IoanTuns/greenhouse_automation_ESP_32_C3_super_mini/hardware/schematic.html

Hardware prototype · schematic reference · rev 1

# Greenhouse Controller — Schematic Prototype

A single-page circuit reference for the ESP32-C3 Super Mini greenhouse automation board, consolidating HARDWARE_CONNECTIONS.md and config_hardware.h into one drawing. This is the basis for the KiCad schematic/PCB files that follow — not a physical footprint layout.

MCUESP32-C3 Super Mini

Power rails12V → 5V → 3.3V

Sensors5 (RTC, baro, RH/T, 2× temp)

Actuators3 relays, 2 solenoids, 1 pump

Flow inputs2 zones, interrupt-driven

GPIOs used16 of 22

## 01 Power distribution

One 12V supply is stepped down twice. The split matters for the board layout: 12V feeds the switched loads directly, 5V feeds motor/coil-side and card logic, and 3.3V is the sensor and relay-logic rail — mixing these up is what damages the ESP32-C3's I/O.

12V feeds the buck converter and the switched valve/pump loads directly; the buck converter's 5V drives the ESP32, relay coil rail, and SD card; a downstream AMS1117 makes the 3.3V rail every sensor and the relay logic side share with the ESP32's own 3V3 pin.

## 02 ESP32-C3 pin assignment

All 16 assigned GPIOs, color-coded by net class. GPIO 8 and 9 carry boot-strapping constraints (LED loading, BOOT button) documented in config_hardware.h — both are safe here because relays default active-LOW/HIGH-off, matching the pins' natural boot state.

Power Ground I2C bus SPI bus Relay output Sensor data Interrupt input

GPIO 11–19 are unused (18/19 reserved for USB-CDC serial). Every non-power, non-ground pin here needs the passive support shown in §03 before it's safe to route to the ESP32.

## 03 Protection circuits

Six passive networks stand between the ESP32-C3 and the outside world. Skipping any one of these is what produces the failure modes already logged in the wiring doc: -127°C readings, CRC errors, boot-loop into download mode, or a fried GPIO.

Relay logic isolation

Removes the VCC↔JD-VCC jumper so onboard pull-ups reference 3.3V, not 5V — keeps GPIO 8/9 under the C3's 3.6V max during boot.

Flow-meter voltage divider

5V × 20k/(10k+20k) = 3.33V at the pin. Required per zone — the bare 5V signal exceeds the GPIO's absolute max and will destroy it.

One-wire & DHT pull-ups

The C3's internal ~45kΩ pull-up is too weak for either protocol. Without these, expect −127°C stub readings or DHT CRC failures.

SD MISO boot-strap pull-up

Without it, a floating tri-stated MISO can read LOW at reset and drop the C3 into ROM download mode instead of booting firmware.

Solenoid flyback diode

Cathode toward +12V, one diode per valve, in parallel with the coil — clamps the collapse spike that would otherwise arc the relay contacts.

Pump RC snubber

R+C in series, wired across relay 1's switched contacts — suppresses arcing on the 220V AC pump circuit specifically.

## 04 Bill of materials

Grouped by role. Passive values match the protection insets above; buy resistors in 1% tolerance for the flow-meter dividers since the 3.33V target sits close to the 3.6V absolute max.

Group | Component | Qty | Spec | Notes
Core | ESP32-C3 Super Mini | 1 | RISC-V, Wi-Fi | Main controller
Core | DS3231 RTC module | 1 | I2C 0x68 | Offline timekeeping
Core | BMP180 barometer | 1 | I2C 0x77 | Shares RTC's I2C bus
Core | DHT22 | 1 | ±0.5°C, ±2% RH | Greenhouse air climate
Core | DS18B20 | 2 | One-Wire | Parallel on one bus
Core | MicroSD card module | 1 | SPI, onboard 3.3V reg. | VCC from 5V rail
Core | 4-channel relay module | 1 | Active-LOW, opto-isolated | 1 channel spare
Core | YF-S201 flow meter | 2 | Hall effect, 5V | Zone 1 / Zone 2
Power | Buck step-down module | 1 | 12V→5V, ≥3A | e.g. LM2596-based
Power | AMS1117-3.3 module | 1 | 5V→3.3V LDO | Sensor + relay-logic rail
Protection | 1N4007 diode | 2 | Flyback | One per solenoid
Protection | RC snubber (100Ω + 0.1µF X2) | 1 | Across relay 1 contacts | Pump arc suppression, 220V AC
Resistor | 1kΩ | 3 | Relay IN series | GPIO5 / 8 / 9 protection
Resistor | 4.7kΩ | 1 | DS18B20 pull-up | GPIO0 → 3.3V
Resistor | 10kΩ | 1 | DHT22 pull-up | GPIO1 → 3.3V
Resistor | 10kΩ | 1 | SD MISO pull-up | GPIO2 → 3.3V, boot strap
Resistor | 10kΩ | 2 | Flow divider R1 | One per flow meter
Resistor | 20kΩ | 2 | Flow divider R2 | One per flow meter
Load | Solenoid valve, 12V | 2 | — | Zone 1 / Zone 2
Load | Water pump, 220V AC | 1 | — | Via relay 1 + snubber

Known open item — GPIO1 (DHT22) had a dead-chip scare on the original board; resolved by chip replacement, not a wiring change. If DHT22/One-Wire/SPI-CS symptoms reappear on this specific ESP32-C3 module, the documented fallback is hardwiring SD CS straight to GND rather than reassigning GPIO1 — keep that in mind when placing the SD footprint.

Sources: HARDWARE_CONNECTIONS.md, config_hardware.h Next: KiCad schematic + PCB skeleton
