IoanTuns/greenhouse_automation_ESP_32_C3_super_mini/hardware/greenhouse_controller.kicad_sch

## KiCad design hardware/greenhouse_controller.kicad_sch (2026-08-18)

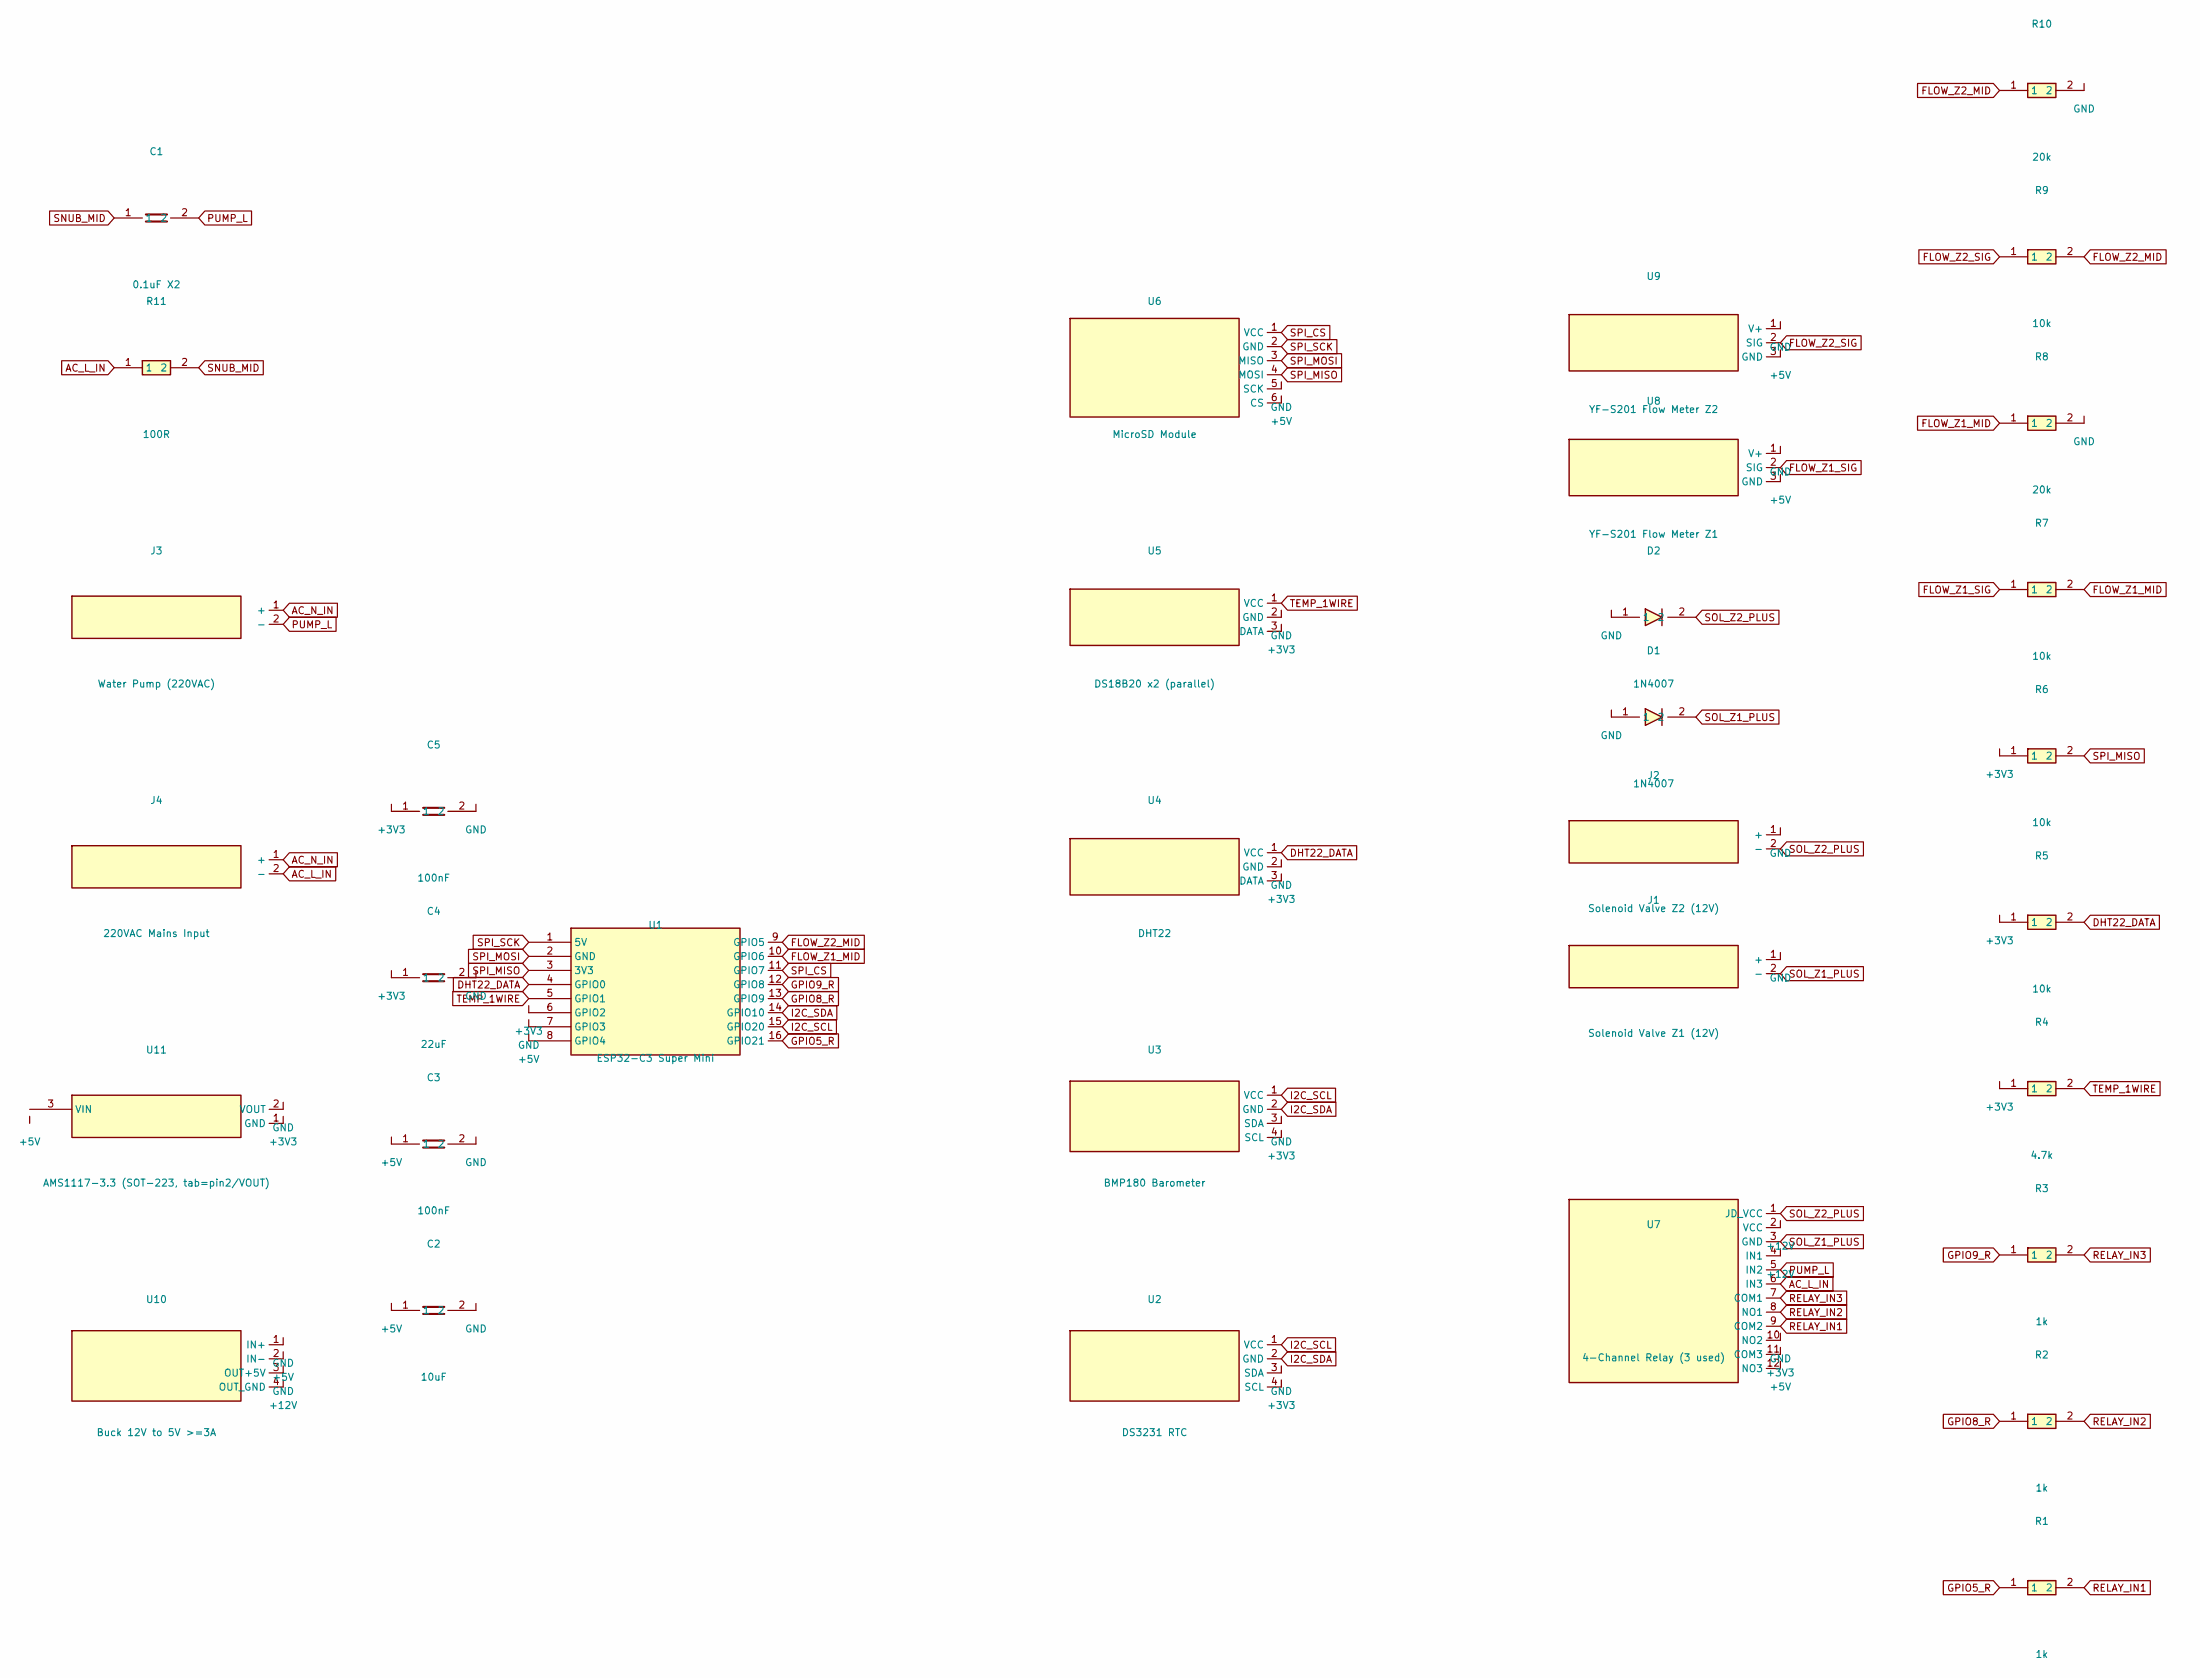
[picture p1: schematic greenhouse_controller.kicad_sch]

Parts:
C1: 0.1uF X2
C2: 10uF
C3, C5: 100nF
C4: 22uF
D1, D2: 1N4007
J1: Solenoid Valve Z1 (12V)
J2: Solenoid Valve Z2 (12V)
J3: Water Pump (220VAC)
J4: 220VAC Mains Input
R1, R2, R3: 1k
R4: 4.7k
R5, R6, R7, R9: 10k
R8, R10: 20k
R11: 100R
U1: ESP32-C3 Super Mini
U2: DS3231 RTC
U3: BMP180 Barometer
U4: DHT22
U5: DS18B20 x2 (parallel)
U6: MicroSD Module
U7: 4-Channel Relay (3 used)
U8: YF-S201 Flow Meter Z1
U9: YF-S201 Flow Meter Z2
U10: Buck 12V to 5V >=3A
U11: AMS1117-3.3 (SOT-223, tab=pin2/VOUT); SOT-223-3_TabPin2

Connections:
+3V3: C4.1, C5.1, R4.1, R5.1, R6.1, U1.6 (GPIO2), U2.4 (SCL), U3.4 (SCL), U4.3 (DATA), U5.3 (DATA), U7.11 (COM3), U11.1 (GND)
+5V: C2.1, C3.1, U1.8 (GPIO4), U6.6 (CS), U7.12 (NO3), U8.3 (GND), U9.3 (GND), U10.2 (IN-)
+12V: U7.2 (VCC), U7.4 (IN1), U10.4 (OUT_GND)
AC_L_IN: J4.2 (-), R11.1, U7.6 (IN3)
AC_N_IN: J3.1 (+), J4.1 (+)
DHT22_DATA: R5.2, U1.4 (GPIO0), U4.1 (VCC)
FLOW_Z1_MID: R7.2, R8.1, U1.10 (GPIO6)
FLOW_Z1_SIG: R7.1, U8.2 (SIG)
FLOW_Z2_MID: R9.2, R10.1, U1.9 (GPIO5)
FLOW_Z2_SIG: R9.1, U9.2 (SIG)
GND: C2.2, C3.2, C4.2, C5.2, D1.1, D2.1, J1.1 (+), J2.1 (+), R8.2, R10.2, U1.7 (GPIO3), U2.3 (SDA), U3.3 (SDA), U4.2 (GND), U5.2 (GND), U6.5 (SCK), U7.10 (NO2), U8.1 (V+), U9.1 (V+), U10.1 (IN+), U10.3 (OUT+5V), U11.2 (VOUT)
GPIO5_R: R1.1, U1.16 (GPIO21)
GPIO8_R: R2.1, U1.13 (GPIO9)
GPIO9_R: R3.1, U1.12 (GPIO8)
I2C_SCL: U1.15 (GPIO20), U2.1 (VCC), U3.1 (VCC)
I2C_SDA: U1.14 (GPIO10), U2.2 (GND), U3.2 (GND)
PUMP_L: C1.2, J3.2 (-), U7.5 (IN2)
RELAY_IN1: R1.2, U7.9 (COM2)
RELAY_IN2: R2.2, U7.8 (NO1)
RELAY_IN3: R3.2, U7.7 (COM1)
SNUB_MID: C1.1, R11.2
SOL_Z1_PLUS: D1.2, J1.2 (-), U7.3 (GND)
SOL_Z2_PLUS: D2.2, J2.2 (-), U7.1 (JD_VCC)
SPI_CS: U1.11 (GPIO7), U6.1 (VCC)
SPI_MISO: R6.2, U1.3 (3V3), U6.4 (MOSI)
SPI_MOSI: U1.2 (GND), U6.3 (MISO)
SPI_SCK: U1.1 (5V), U6.2 (GND)
TEMP_1WIRE: R4.2, U1.5 (GPIO1), U5.1 (VCC)
