IoanTuns/greenhouse_automation_ESP_32_C3_super_mini/src/main.cpp

#include <Arduino.h>
#include "globals.h"
#include "rtc_module.h"
#include "sensors.h"
#include "irrigation.h"
#include "sd_logger.h"
#include "web_server.h"
#include "app_settings.h"

void setup() {
    // Relays OFF first — relay module's 5V pull-ups are on GPIO 8/9; driving them HIGH
    // (RELAY_OFF) immediately prevents 5V from backfeeding into the 3.3V GPIO inputs.
    initRelays();

    Serial.begin(115200);
    { unsigned long t = millis(); while (!Serial && millis() - t < 3000) delay(10); }
    Serial.println("\n--- Smart Greenhouse Automation System ---");

    loadAppSettings();
    initWebServer();
    rtcAvailable = initRTC();
    initSD();
    initSensors();
    initIrrigation();

    Serial.println("--- Initialization Complete ---\n");
}

void loop() {
    webServerLoop();
    rtcRetryLoop();
    sdRetryLoop();
    irrigationLoop();
    sensorsLoop();
    sdLoggerLoop();
}
